Dattelklauber/taktwerk/block_diagram.png

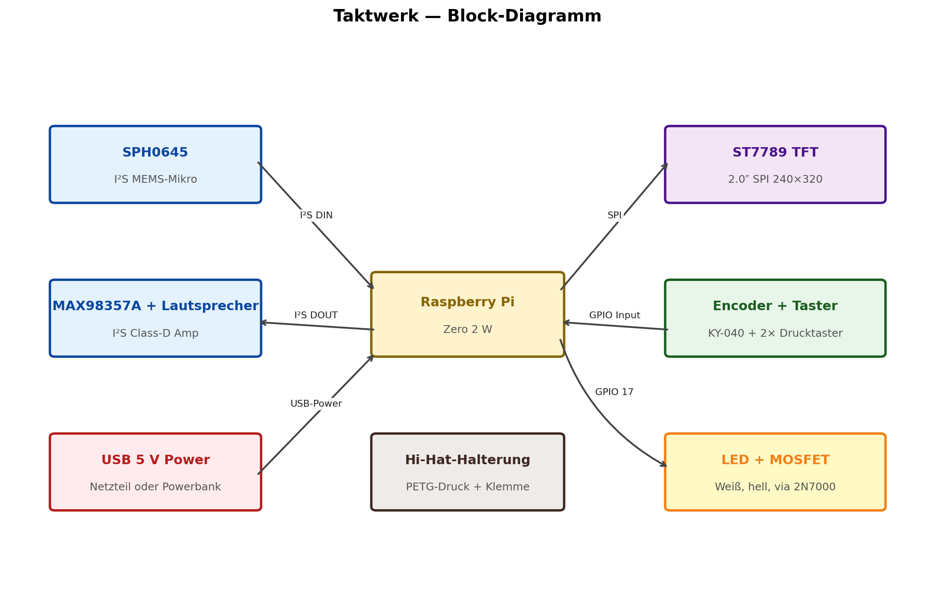
block_diagram.png
