Dattelklauber/taktwerk/preview_3q_final.png

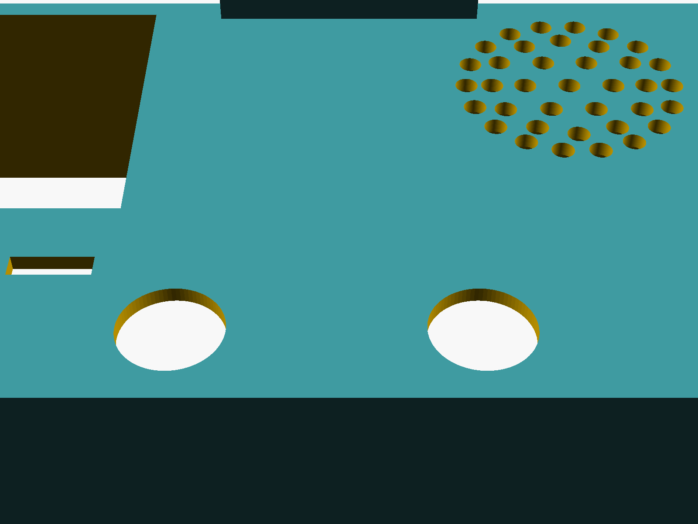
preview_3q_final.png
