Dattelklauber/taktwerk/preview_clamp_final.png

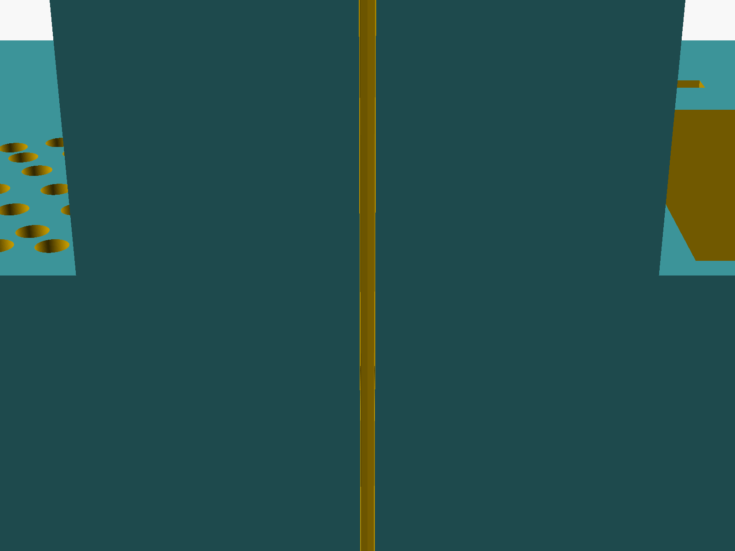
preview_clamp_final.png
