Dattelklauber/taktwerk/preview_top_final.png

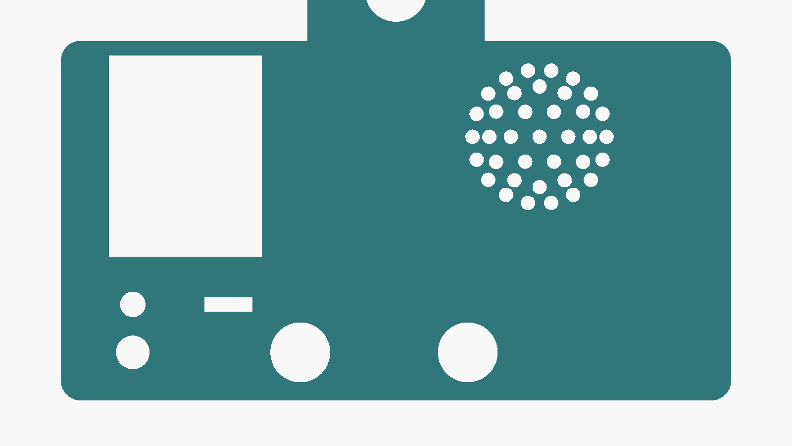
preview_top_final.png
