Dattelklauber/taktwerk/schematic.png

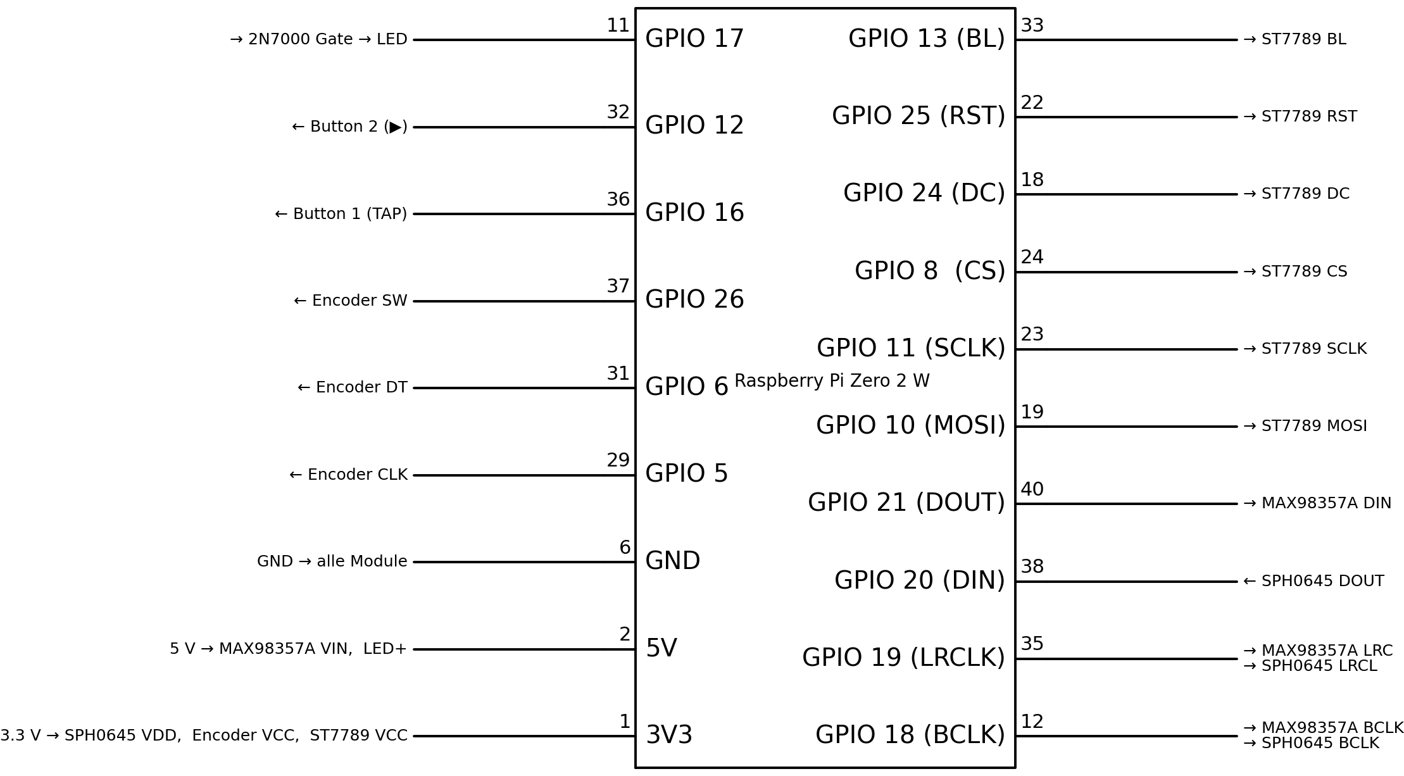
schematic.png
