Dattelklauber/taktwerk/taktwerk_case_main.stl

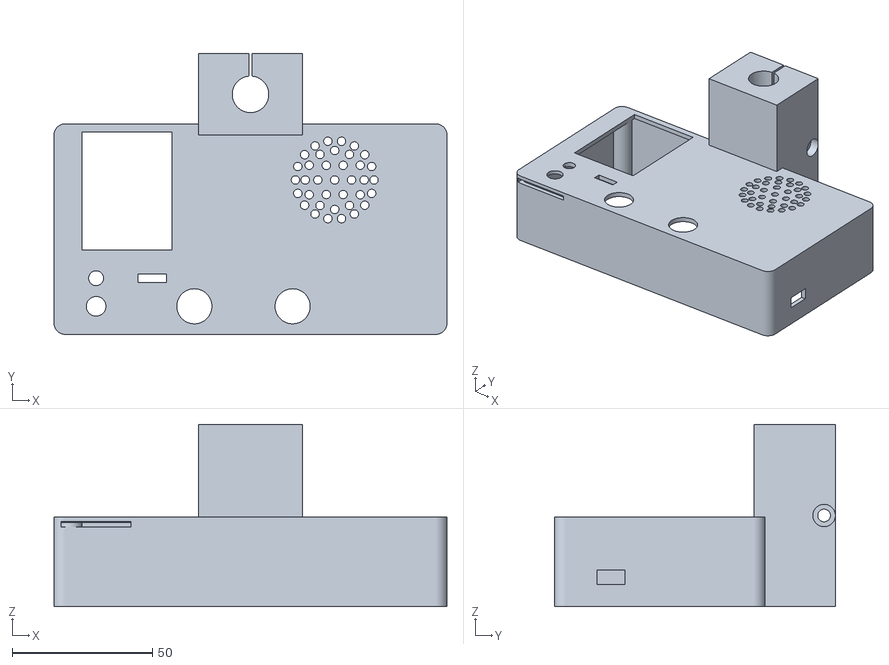
[picture p6: CAD file, 2026-05-24]
taktwerk_case_main.stl
140.0 x 100.0 x 65.0
