Dattelklauber/taktwerk/taktwerk_case_base.stl

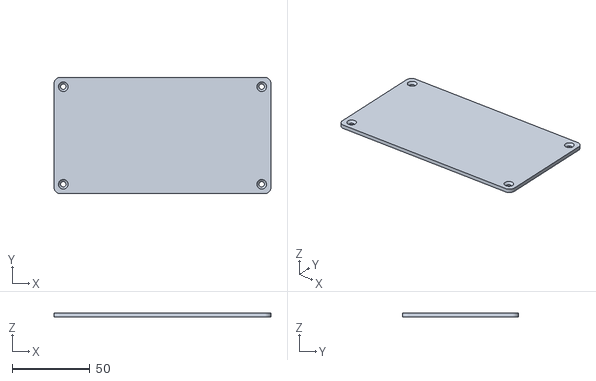
[picture p7: CAD file, 2026-05-24]
taktwerk_case_base.stl
140.0 x 75.0 x 2.50
