Dattelklauber/taktwerk/wiring_diagram.png

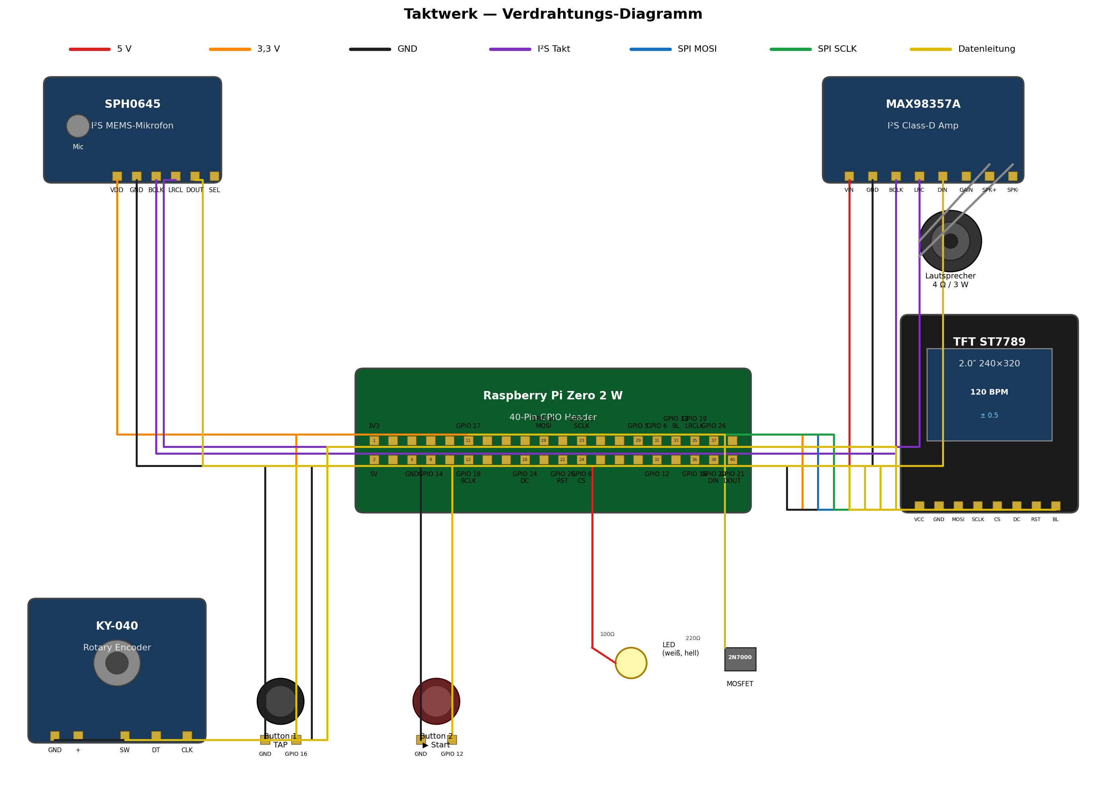
wiring_diagram.png
