Dattelklauber/taktwerk/(commit log)

2026-05-23 Add audio test protocol, --record flag, schematic + Amazon shopping list
2026-05-23 Replace synthetic clicks with realistic drum synthesis (kick, snare, hi-hat)
    [generate_test_audio.py]
2026-05-23 Different drum sound per click track section + punchier individual drums
2026-05-23 Drop onset detector floor, tighter beat tracker sigma, 1-bar count-in default
    [tempo_monitor.py]
2026-05-23 Louder count-in clicks with console echo, clipping warning in web UI, TD-27 cable + USB audio in shopping list
2026-05-23 Add Fritzing-style wiring diagram to build manual
2026-05-23 Add parametric OpenSCAD case design with hi-hat clamp
    [taktwerk_case.scad]
2026-05-24 Fixed case design: proper top wall with cutouts, layout cleanup, simpler speaker holes
    [taktwerk_case.scad, taktwerk_case_base.stl, taktwerk_case_main.stl]
2026-05-24 Fix z-fighting: speaker holes extend through wall, all cutouts now render correctly
    [taktwerk_case.scad, taktwerk_case_main.stl]
